Rofta/Brake-System-Plausibility-Device/README.md

# Brake-System-Plausibility-Device
A Brake System Plausibility Device (BSPD) is a critical safety circuit in electric race cars that prevents unintended acceleration during braking by monitoring brake pressure and motor power.
