Rofta/Brake-System-Plausibility-Device/(list of files, drawings)

Other design files:
BSPDSchematic.SchDoc
PCB Layout.PcbDoc
